enercade/lumina-opensource/lumina-mech/README.md

# Lumina mechanics

3D-printable mechanical parts (STL) for the Lumina enclosure.

**Coming soon** — the models are being finalised and will be published here together with printing guidelines (material, orientation, settings).

## License

CERN Open Hardware Licence Version 2 — Weakly Reciprocal (CERN-OHL-W v2) — see [LICENSE](LICENSE).
Copyright © 2026 Enercade srl, Torino, Italy.
