enercade/lumina-opensource/lumina-hw/fabrication/BOM-luminaA00.xlsx

Quantity | Comment | Designator | Footprint | JLCPCB Part #
1 | ESP32-C6-MINI-1-N4 | BRD1 | ESP32-C6-MINI-1 | C5736265
1 | AP62250WU-7 | U3 | SOT95P280X100-6N | C5184228
1 | 2-1825910-2 | SW3 | 2-1825910-2 | C2928199
1 | SRN4018-2R2M | L1 | SRN4018 | C2903010
1 | PMV65XPEAR | Q1 | SOT-23-3 | C2889116
12 | WS2812B-V5/W | D2, D3, D4, D5, D6, D7, D8, D9, D10, D11, D12, D13 | WS2812B | C2874885
1 | MH3261-601Y | FB3 | IND_1206_N | C840591
2 | 1-1825027-7 | SW4, SW5 | 1-1825027-7 | C592923
1 | S1K-13-F | D15 | DO-214AC (SMA) | C507833
1 | BZX84C10 | D1 | SOT-23-3 | C235751
1 | 1812L160PR | PTC1 | RES_1812_N | C207073
1 | KLJ-8530-3627 | LS1 | XDCR_CMT-8504-100-SMT-TR | C189206
1 | DMN2004DWK-7 | Q2 | SOT363 (TSSOP6) | C156343
1 | USB4105 | CN3 | GCT_USB4105-GF-A | C136423
2 | C0805 | C14, C47 | CAP_0805_N | C98190
3 | C0805 | C1, C33, C34 | CAP_0805_N | C98190
1 | 1825027-5 | SW1 | 1825027-5 | C86476
1 | C0603 | C3 | CAP_0603_N | C29936
1 | R0603 | R30 | RES_0603_N | C25967
7 | R0603 | R6, R7, R10, R11, R13, R16, R32 | RES_0603_N | C25804
1 | R0603 | R34 | RES_0603_N | C25803
2 | R0603 | R1, R2 | RES_0603_N | C23186
1 | R0603 | R5 | RES_0603_N | C22978
5 | R0603 | R3, R8, R9, R12, R46 | RES_0603_N | C22775
1 | R0603 | R33 | RES_0603_N | C21190
1 | C0805 | C30 | CAP_0805_N | C15850
1 | C0603 | C32 | CAP_0603_N | C14858
19 | C0603 | C2, C4, C5, C8, C17, C18, C19, C20, C21, C22, C23, C24, C25, C26, C27, C28, C29, C31, C35 | CAP_0603_N | C14663
1 | USBLC6-2 | U1 | SOT-23-6 | C7519
1 | 50C02CH-TL-E | Q4 | SOT-23-3 | C2150
