enercade/lumina-opensource/lumina-hw/step/STEP-luminaA00.step

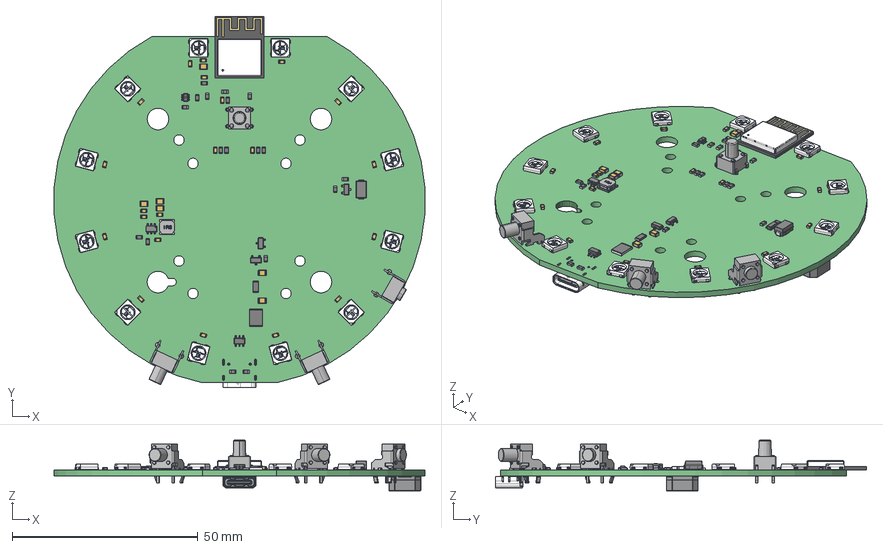
[picture p2: CAD file, 2026-07-09]
lumina-hw/step/STEP-luminaA00.step
99.8 x 99.8 x 13.7 mm
c-2-1825910-2-c-3d_RGB8421504
CUI_DEVICES_CMT-8504-100-SMT-TR
Mid_Body x 19
Mark x 19
c-1-1825027-7-h-3d_RGB8421504 x 2
SOT353 Lower body
SOT353 Lead x 6
SOT353 Upper body
Leader x 9
Lead x 2
SRN4018-221M_RGB8421504 x 2
c-1825027-5-h-3d_RGB8421504
ws2812B x 12
uid__2428
R0201_20210301.xtd x 3
L0201_20210301.xtd x 2
C0201_20210301.xtd x 10
ESP32-C6_QFN32_5X5_202306.xtd
XTAL3225_20210301.xtd
DFN1006.xtd
C0402_20210301.xtd
placementOutline_18
placementOutline_19
placementOutline_20
placementOutline_21
placementOutline_22
placementOutline_23
placementOutline_24
MINI-ANT-TYPE-D-H-top
MINI-ANT-TYPE-D-H-buttom
C3-MINI-solder_pad
ShieldBox_ESP32-C3-MINI-1_V1.0_20200901
USB4105-GF-A_PART1
USB4105-GF-A_PART2
