enercade/lumina-opensource/lumina-hw/pdf/schematic-luminaA00.PDF

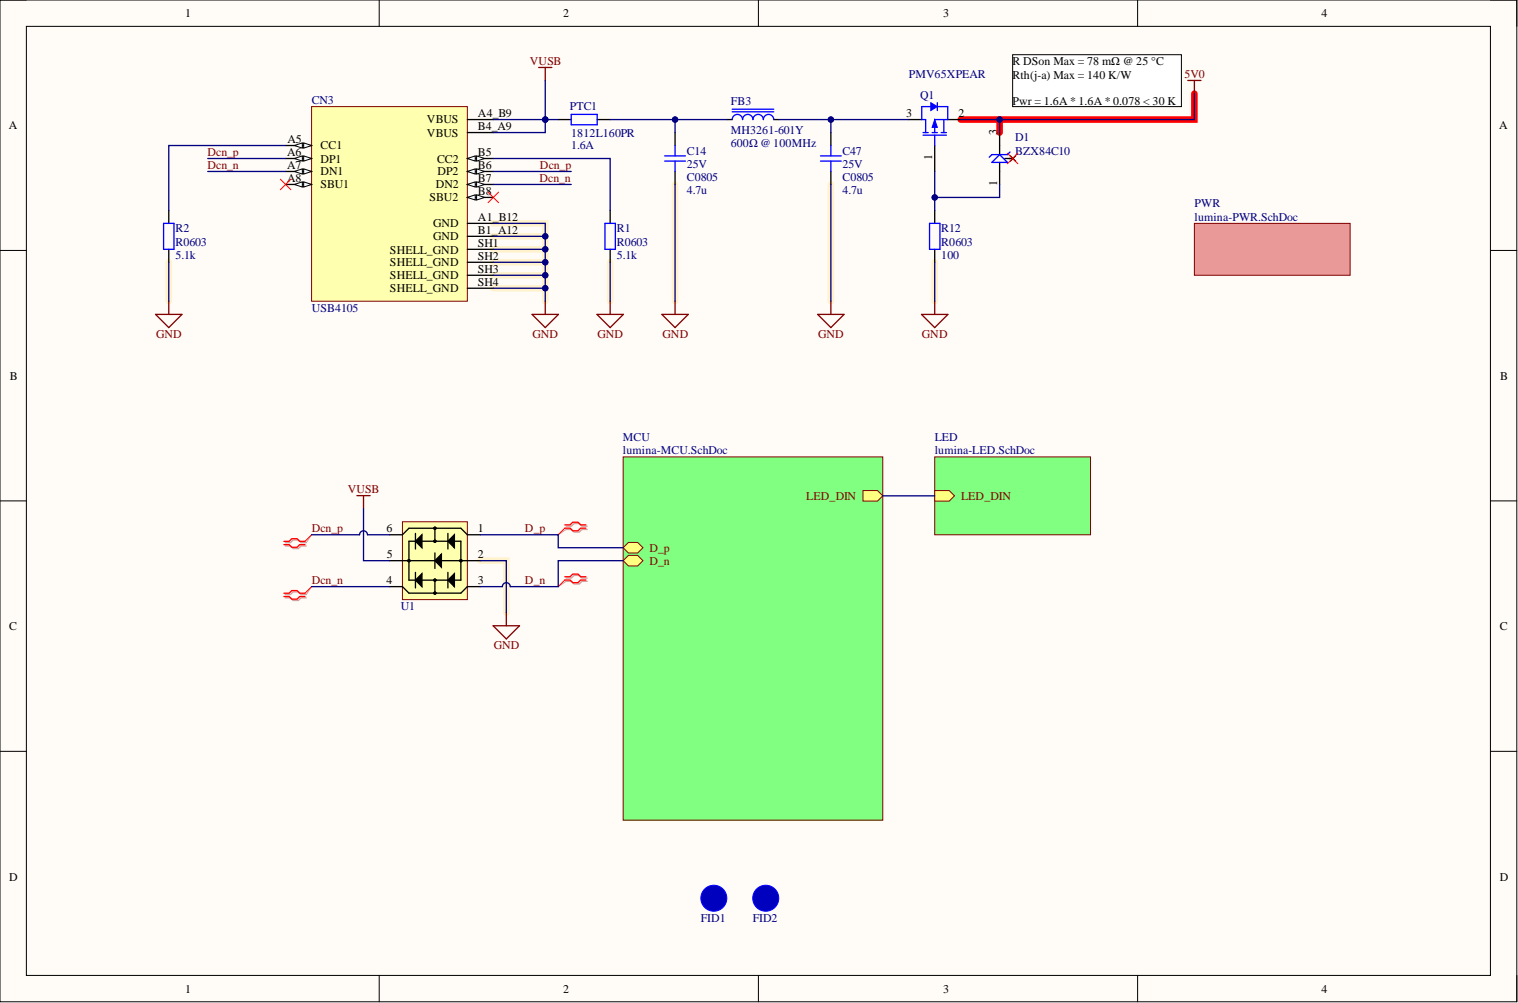
[picture p3: page 1]

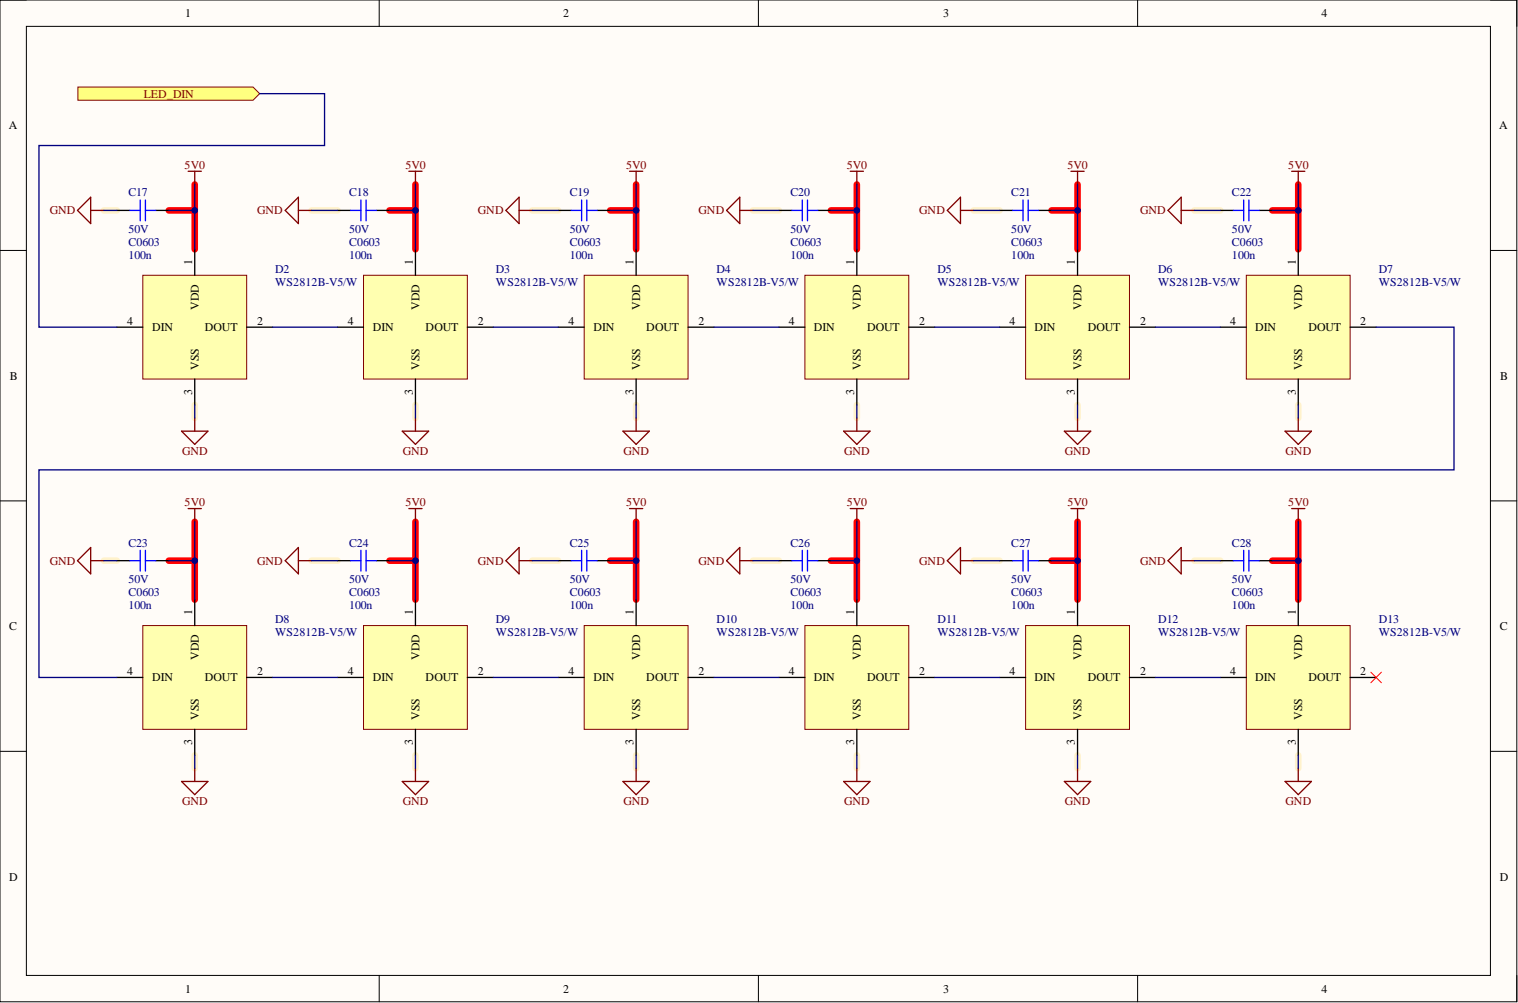
[picture p4: page 2]

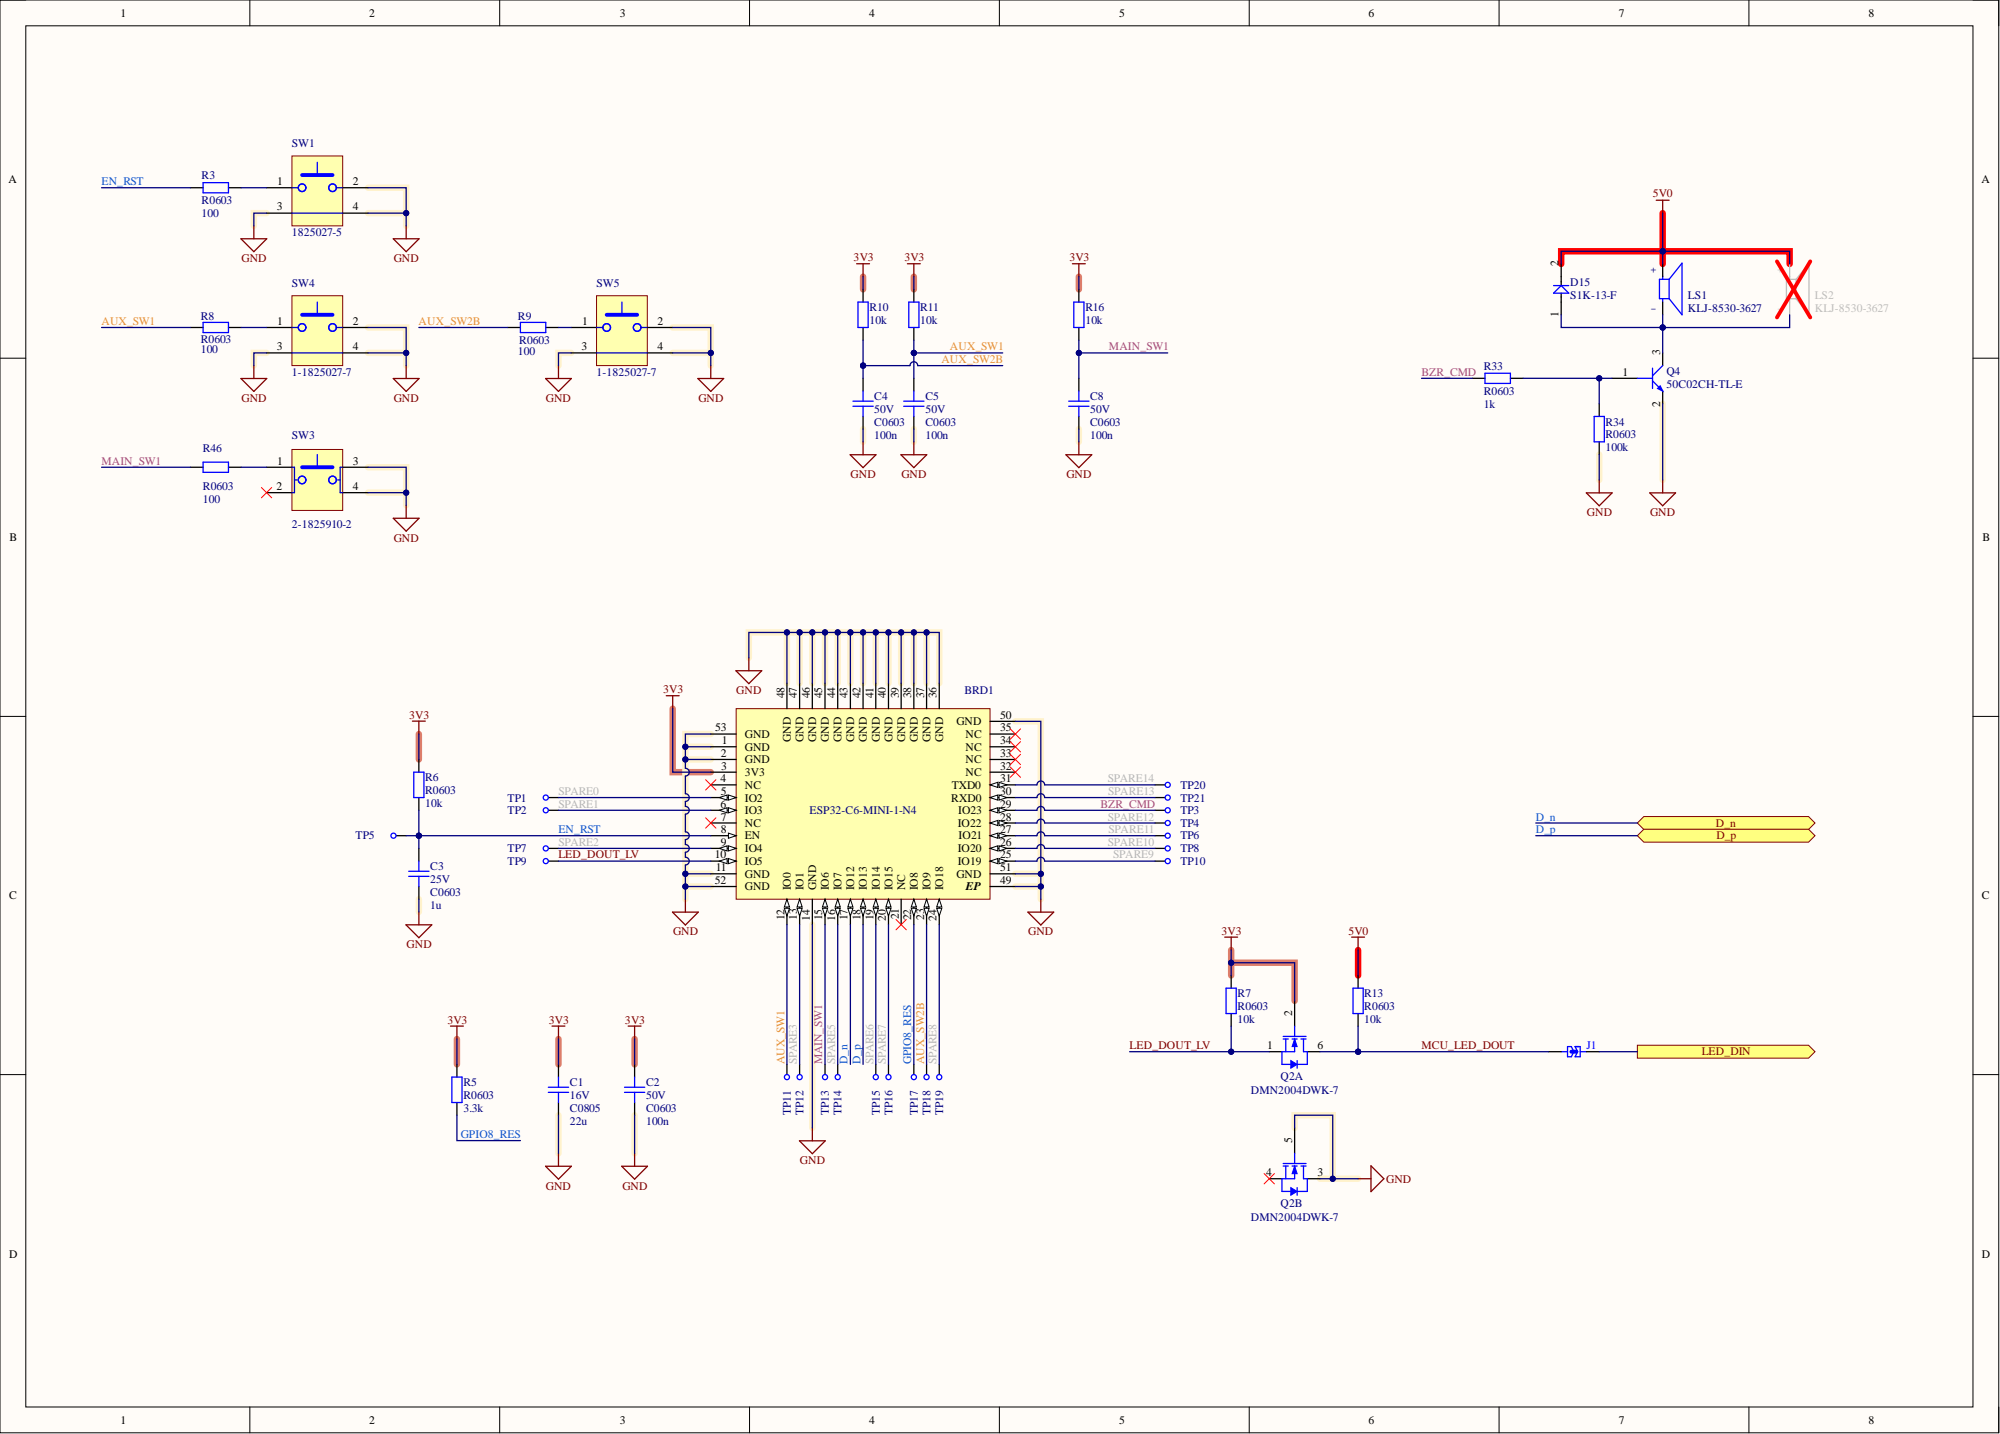
[picture p5: page 3]

GND 36 GND 37 GND 38 GND 39 GND 40 GND 41 GND 42 GND 43 GND 44 GND 45 GND 46 GND 47 GND 48

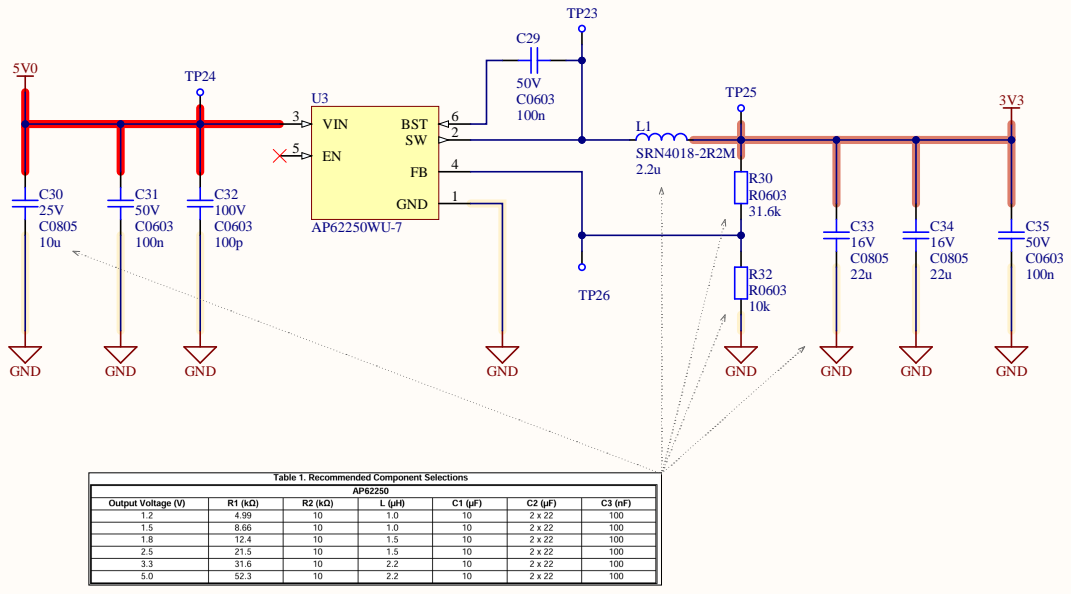
[picture p6: page 4]
