enercade/lumina-opensource/lumina-hw/pdf/drawing-luminaA00.PDF

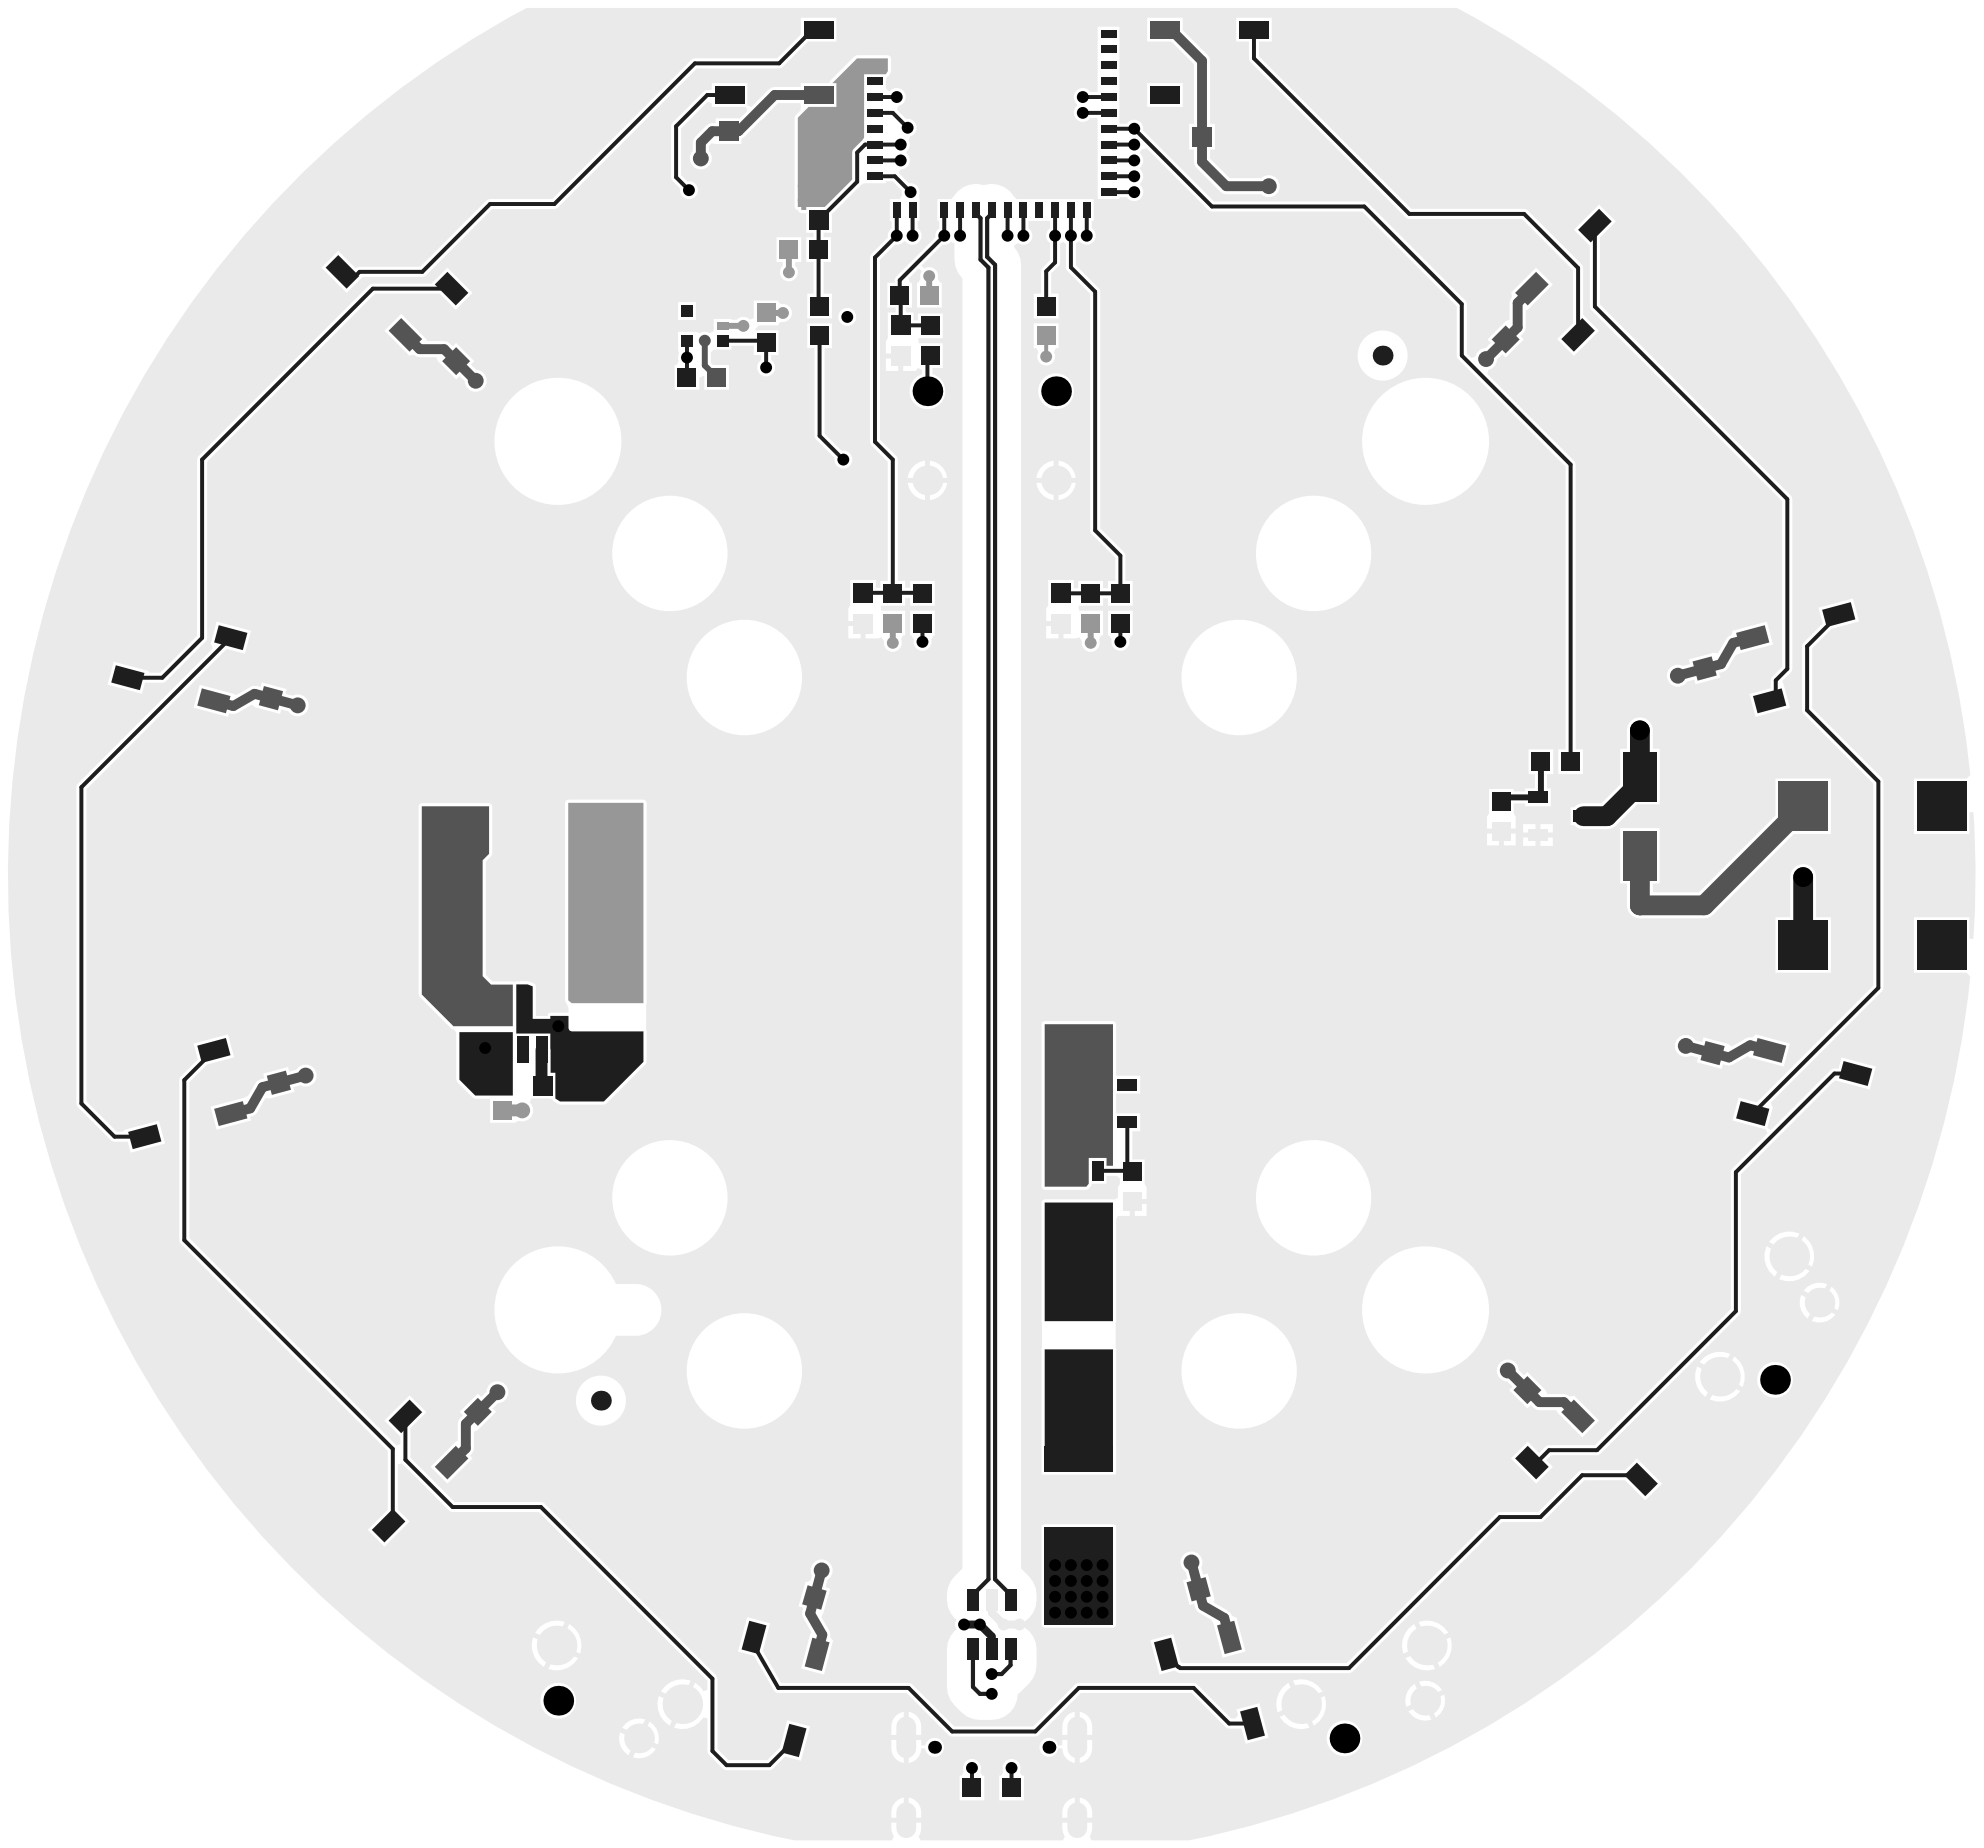
[picture p7: page 1]

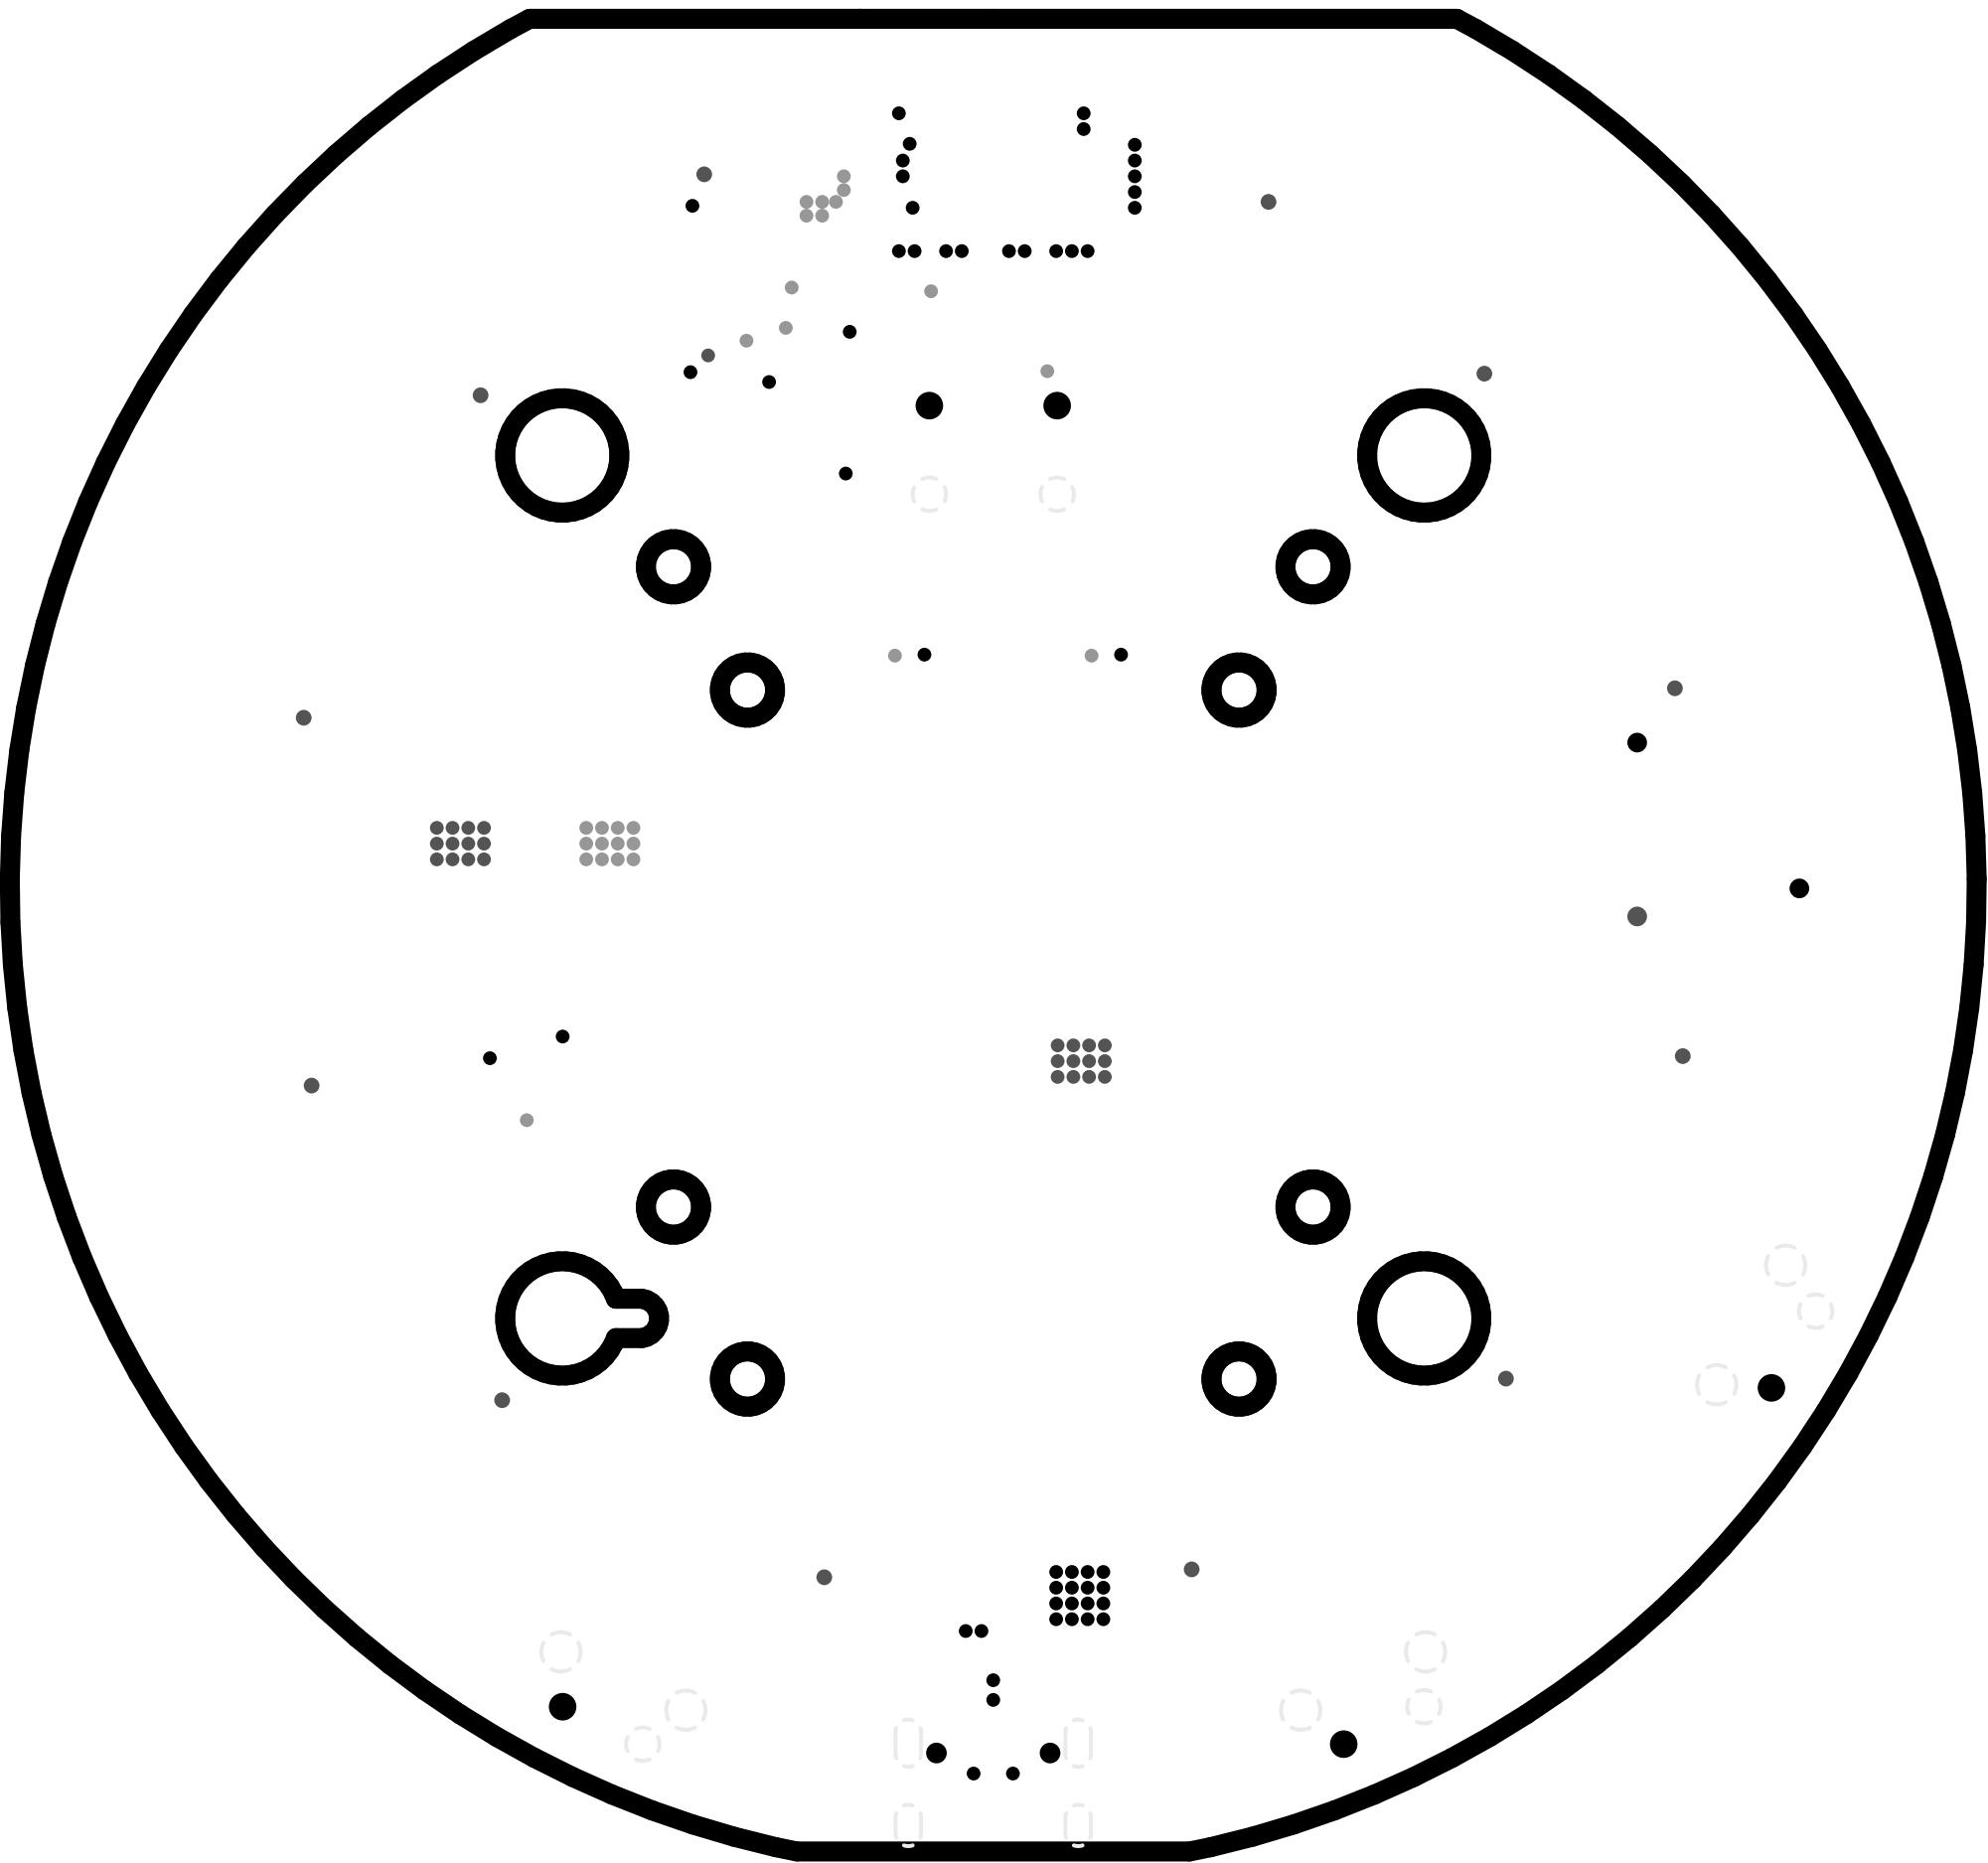
[picture p8: page 2]

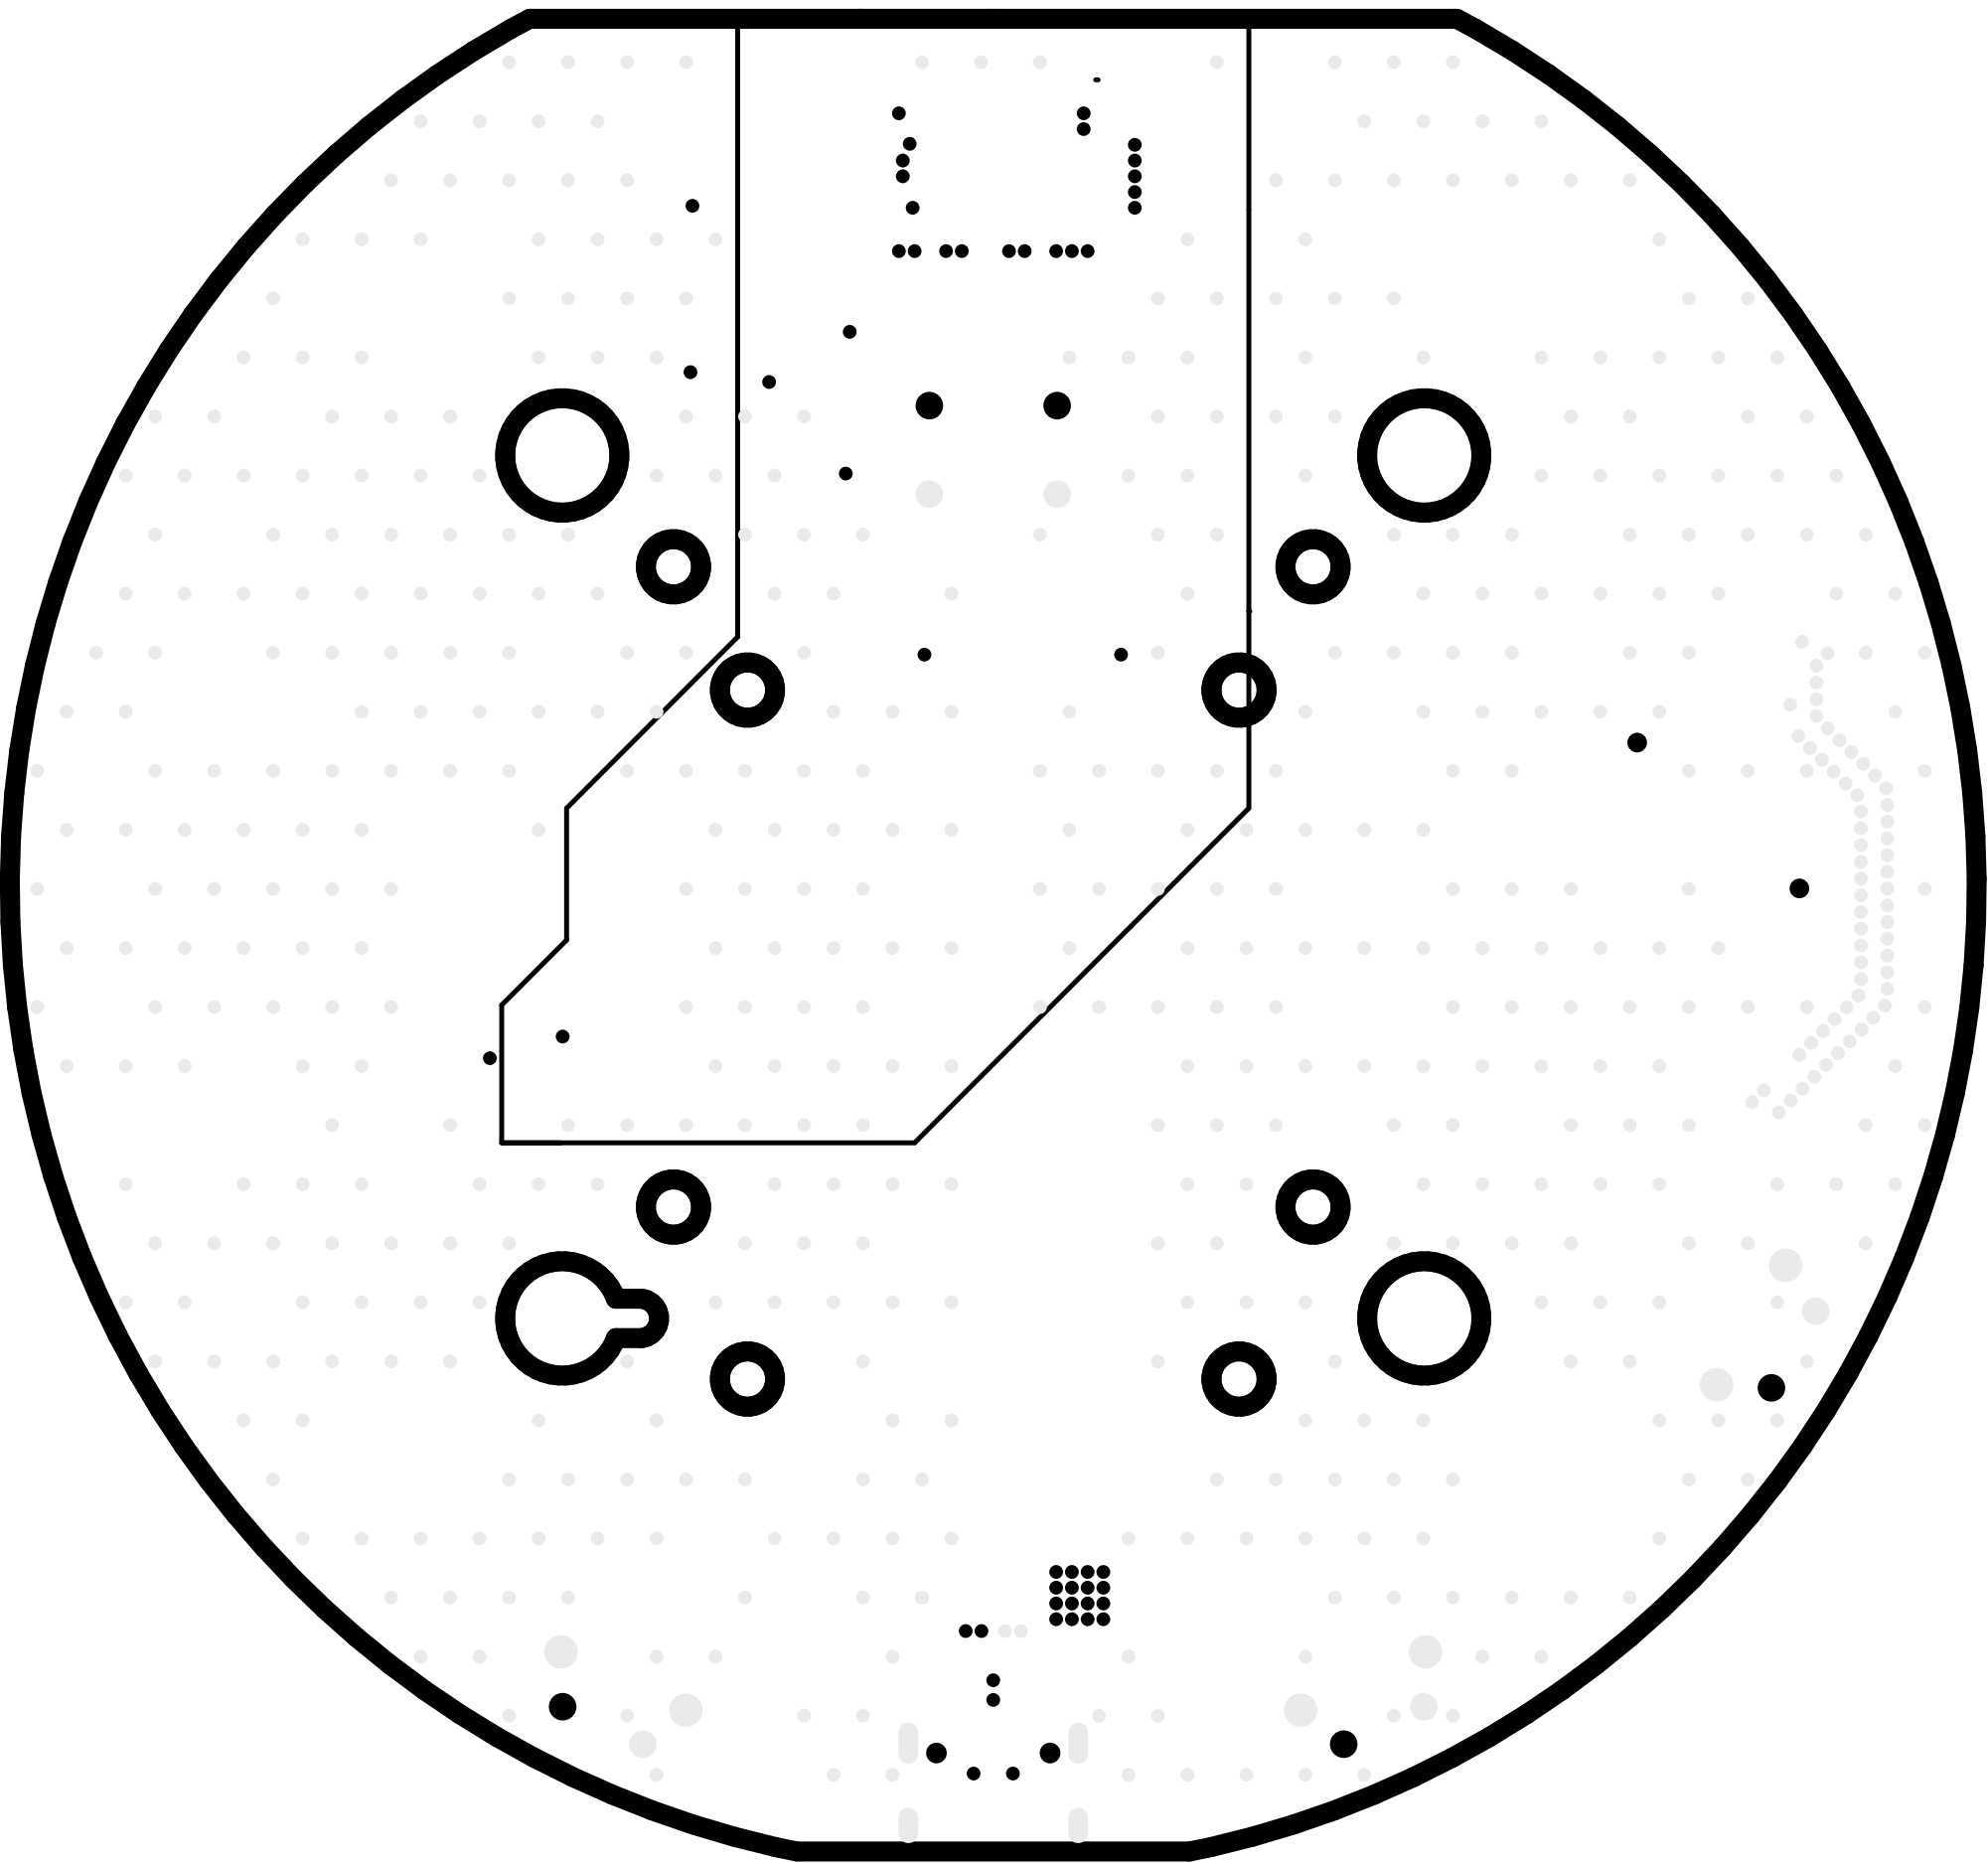
[picture p9: page 3]

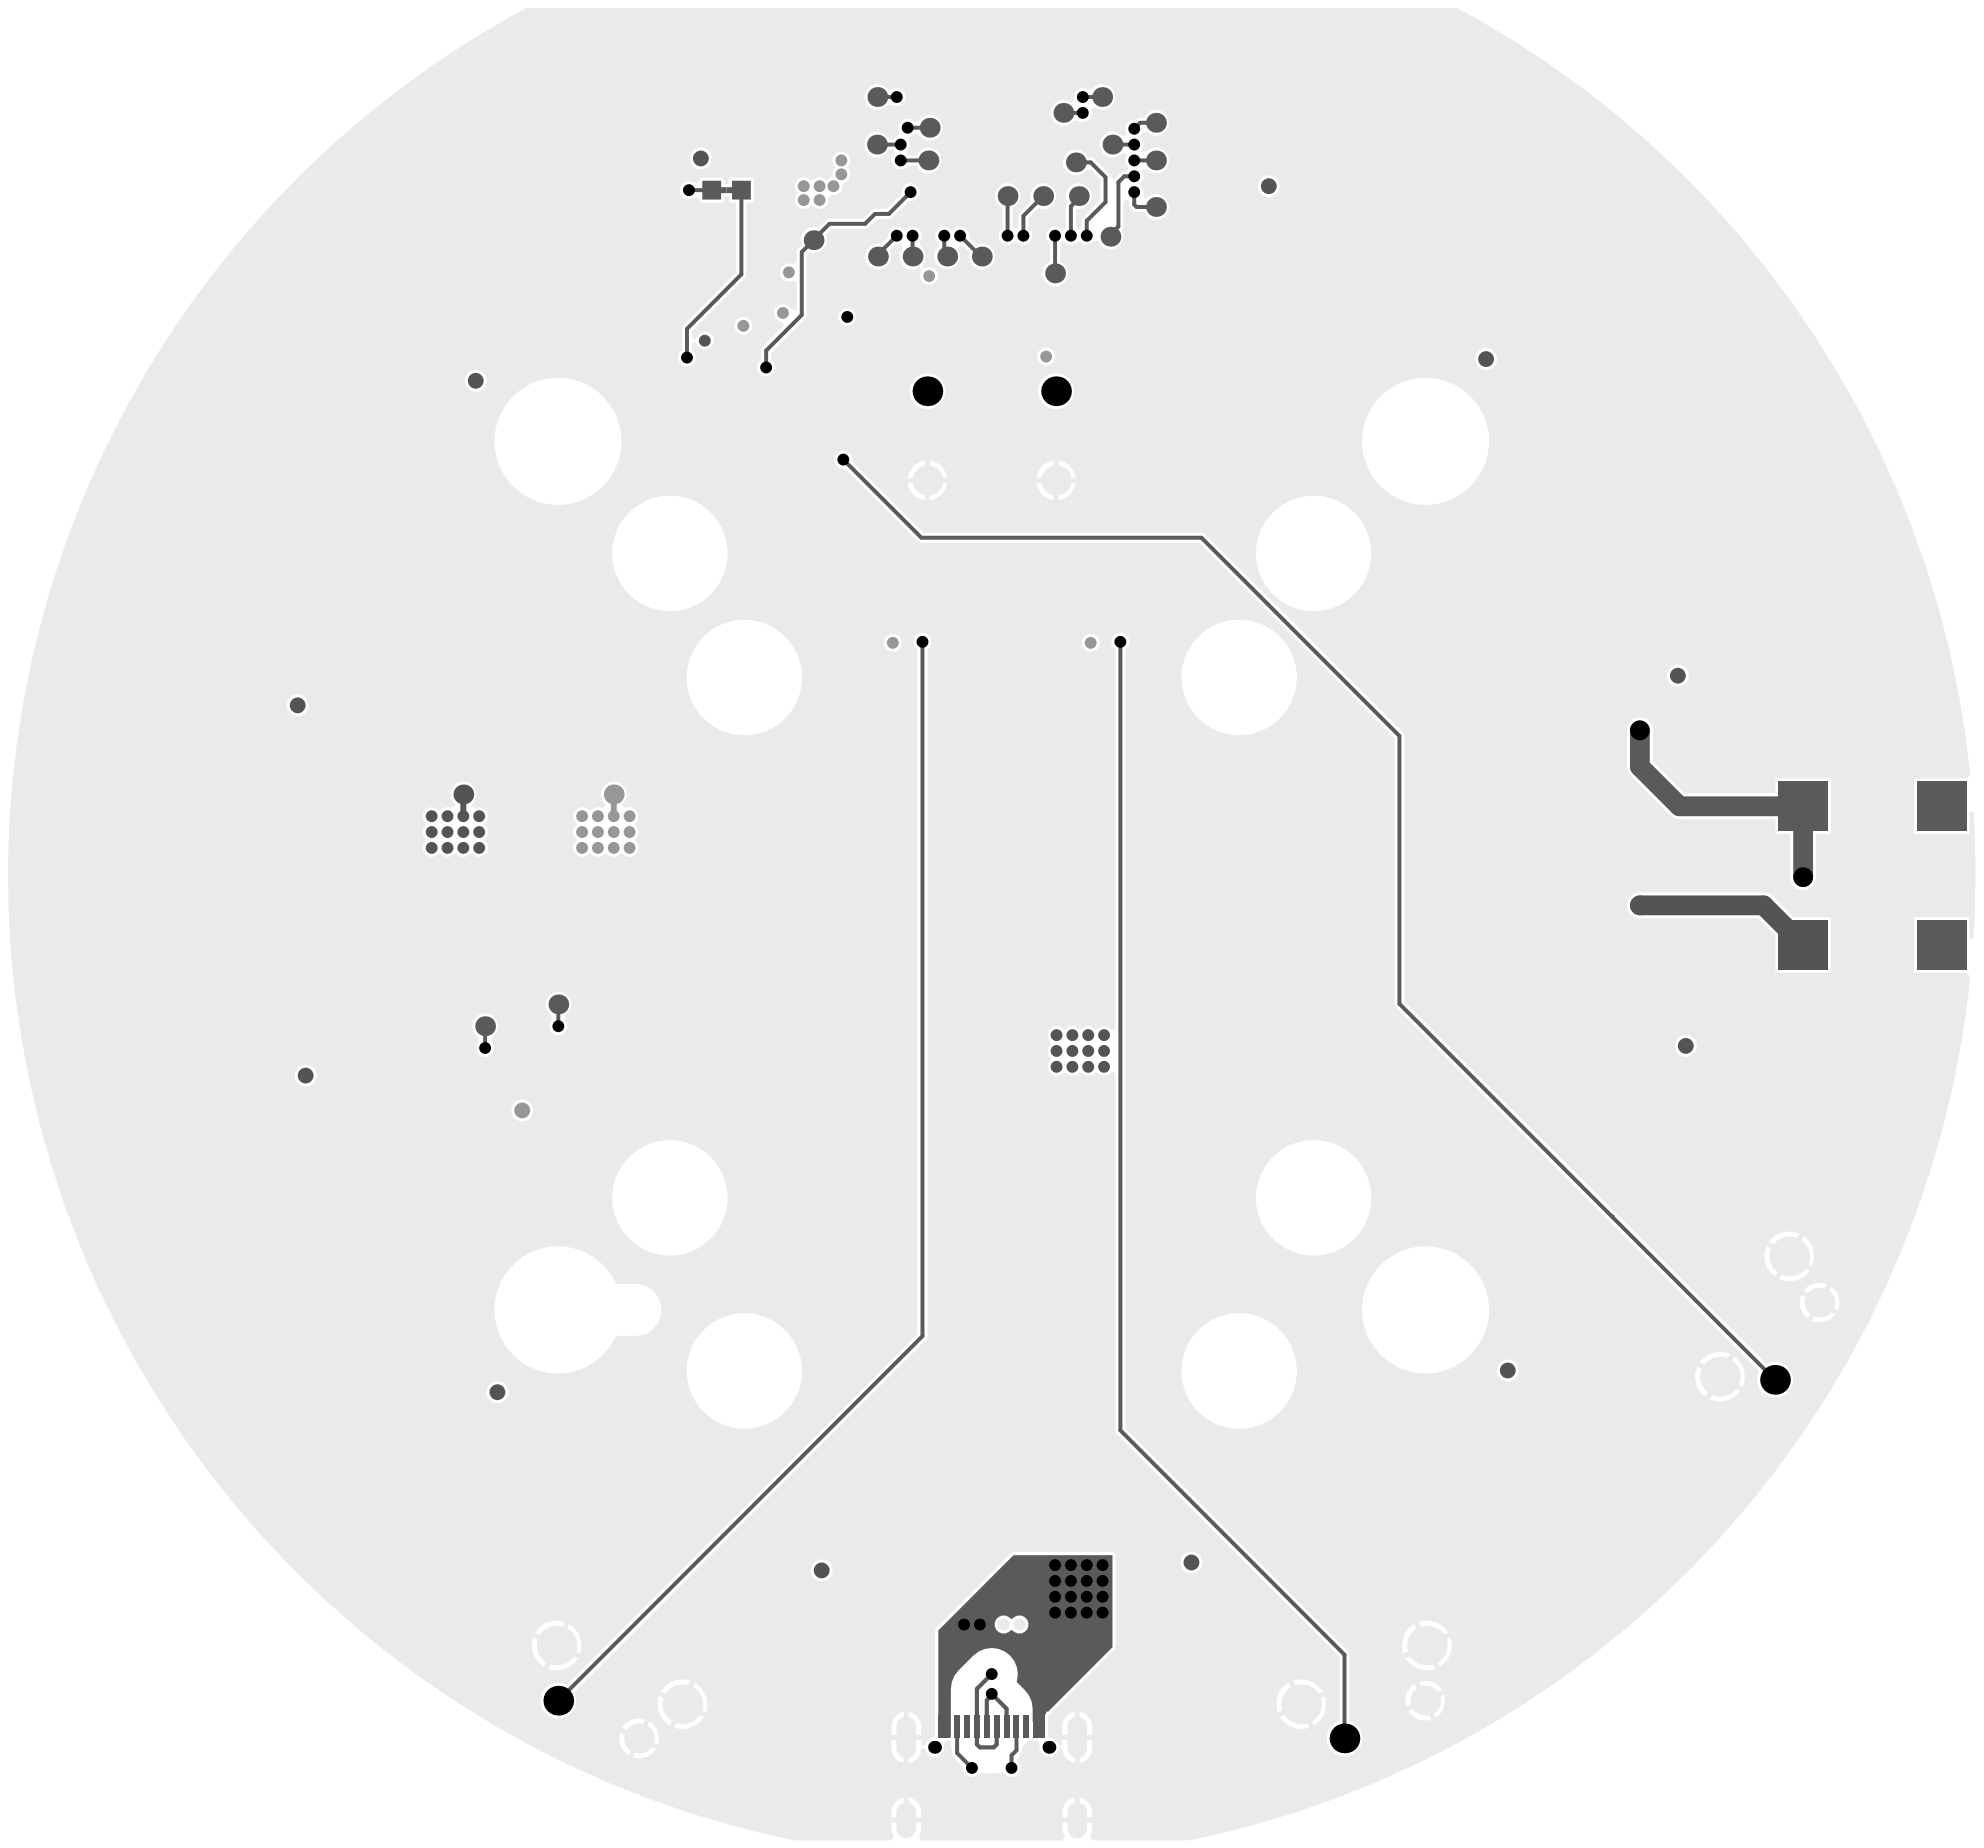
[picture p10: page 4]
